malipek/battery_charging_monitor/(commit log)

2023-02-07 SPI SD card reader tests
2023-02-11 I2C LCD tests, I2C changed from pin D1 (stopped working)
2023-02-11 Restored I2C on D1,D2, returned to SD Card tests, added diagrams
2023-02-11 Negative voltage generator added to diagram
2023-02-11 Module boundary added, voltage stabiliser added, minor corrections in schema
2023-09-27 Fixed current counting, added SH1106 OLED dispay
2024-02-26 Fix for AUTO mode, for discharging. Doc added.
    [battery_charging_monitor.ino]
2024-03-16 Fixed uC crash when in SD mode only
    [battery_charging_monitor.ino]
